gerryc89/Trigorilla-Pro/trigorilla_pro.sch

## EAGLE design trigorilla_pro.sch (2020-04-10)

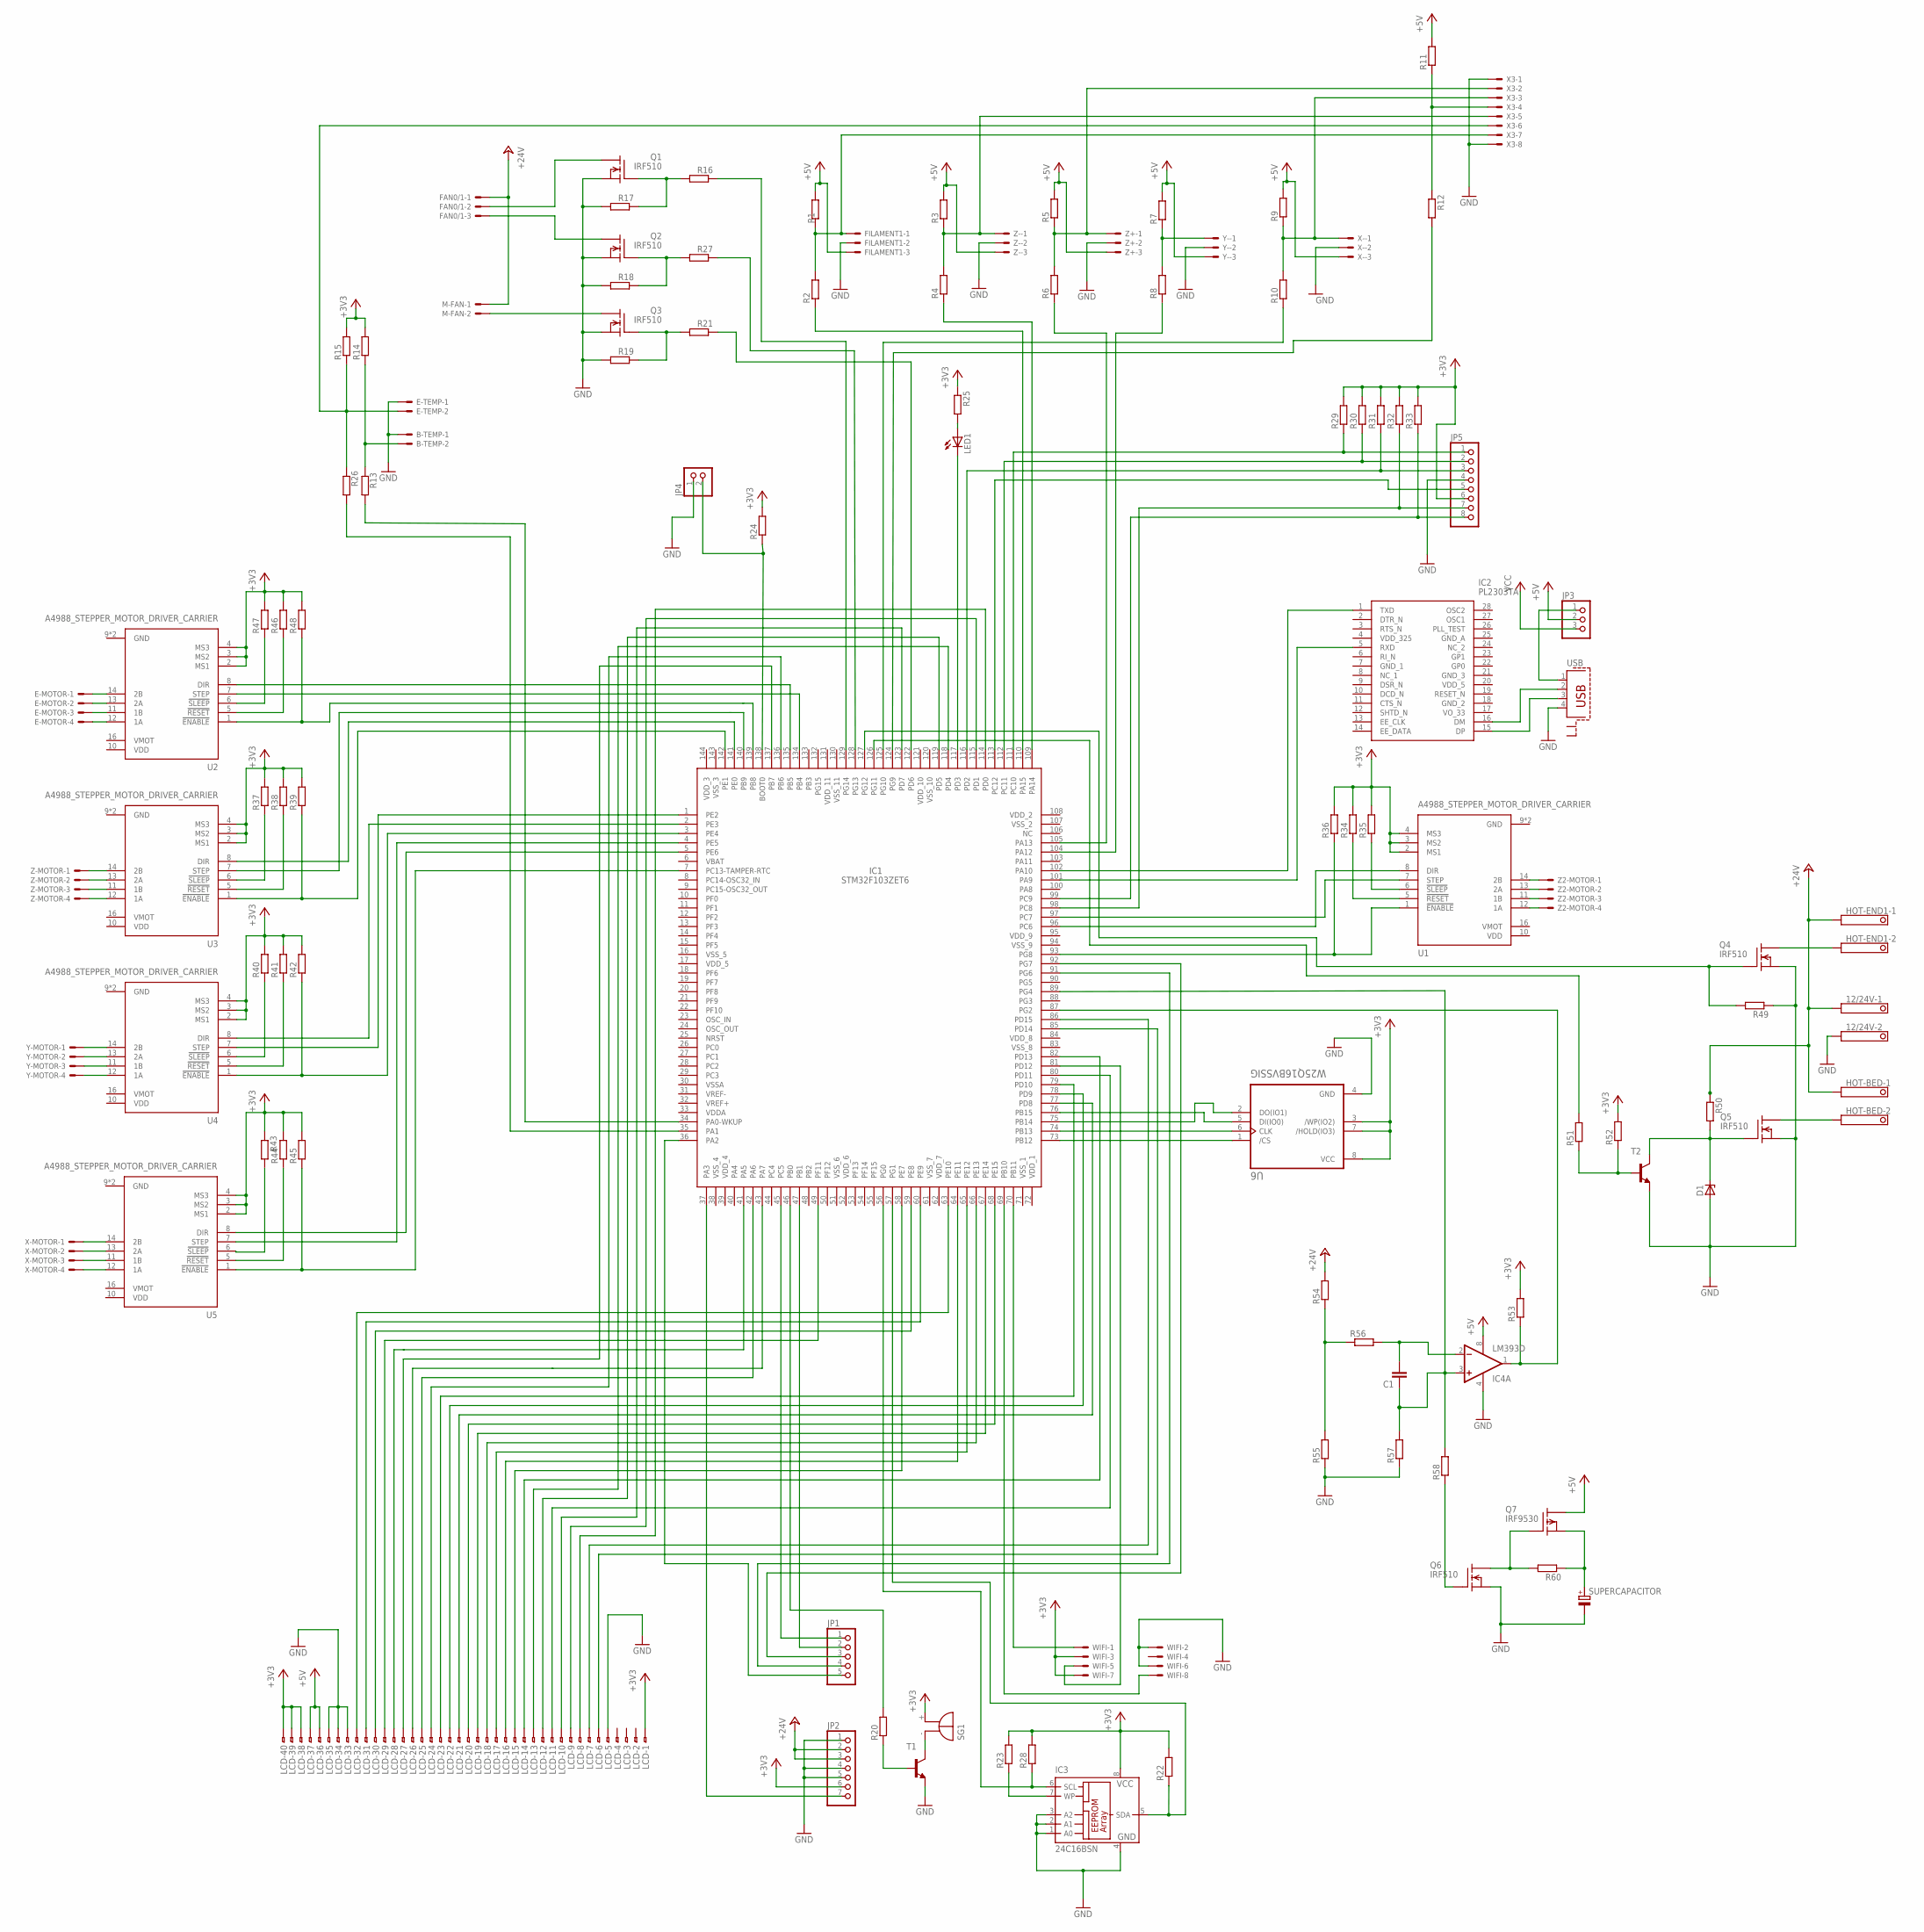
[picture p1: schematic trigorilla_pro.sch]

Parts:
12/24V: 1751248
B-TEMP: C-GRID-02-70543; 70543-02
C1: C-EUC0805; C0805
D1: ZENER-DIODESOD80C; SOD80C
E-MOTOR: C-GRID-04-70543; 70543-04
E-TEMP: C-GRID-02-70543; 70543-02
FAN0/1: C-GRID-03-70543; 70543-03
FILAMENT1: C-GRID-03-70543; 70543-03
HOT-BED: 1751248
HOT-END1: 1751248
IC1: STM32F103ZET6; QFP50P2200X2200X160-144N
IC2: PL2303TA; SOP65P780X200-28N
IC3: 24C16BSN; SO-08
IC4: LM393D; SO08
JP1: PINHD-1X5; 1X05
JP2: PINHD-1X7; 1X07
JP3: PINHD-1X3; 1X03
JP4: PINHD-1X2; 1X02
JP5: PINHD-1X8; 1X08
LCD: FH12-40S-0.5SH
LED1: LED; SMARTLED-TTW
M-FAN: C-GRID-02-70543; 70543-02
Q1, Q2, Q3, Q4, Q5, Q6: IRF510; TO220
Q7: IRF9530; TO220
R1, R2, R3, R4, R5, R6, R7, R8, R9, R10, R11, R12, R13, R14, R15, R16, R17, R18, R19, R20, R21, R22, R23, R24, R25, R26, R27, R28, R29, R30, R31, R32, R33, R34, R35, R36, R37, R38, R39, R40, R41, R42, R43, R44, R45, R46, R47, R48, R49, R50, R51, R52, R53, R54, R55, R56, R57, R58, R60: R-EU_M0805; M0805
SG1: F/QMBIII
SUPERCAPACITOR: CPOL-EUE10-22.5; EB22,5D
T1, T2: BC817-40-NPN-SOT23-BEC; SOT23-BEC
U1, U2, U3, U4, U5: A4988_STEPPER_MOTOR_DRIVER_CARRIER; MODULE_A4988_STEPPER_MOTOR_DRIVER_CARRIER
U6: W25Q16BVSSIG; SOIC127P790X216-8N
USB: PN61729-S
WIFI: 87758-0816
X3: C-GRID-08-70543; 70543-08
X-: C-GRID-03-70543; 70543-03
X-MOTOR: C-GRID-04-70543; 70543-04
Y-: C-GRID-03-70543; 70543-03
Y-MOTOR: C-GRID-04-70543; 70543-04
Z2-MOTOR: C-GRID-04-70543; 70543-04
Z+: C-GRID-03-70543; 70543-03
Z-: C-GRID-03-70543; 70543-03
Z-MOTOR: C-GRID-04-70543; 70543-04

Connections:
+3V3: IC3.8 (VCC), JP2.6, JP5.6, LCD.1, LCD.38, LCD.39, LCD.40, R14.2, R15.2, R22.2, R23.2, R24.2, R25.1, R28.2, R29.2, R30.2, R31.2, R32.2, R33.2, R34.2, R35.2, R36.2, R37.2, R38.2, R39.2, R40.2, R41.2, R42.2, R43.1, R44.2, R45.2, R46.2, R47.2, R48.2, R52.2, R53.2, SG1.+ (-), U1.2 (MS1), U1.3 (MS2), U1.4 (MS3), U2.2 (MS1), U2.3 (MS2), U2.4 (MS3), U3.2 (MS1), U3.3 (MS2), U3.4 (MS3), U4.2 (MS1), U4.3 (MS2), U4.4 (MS3), U5.2 (MS1), U5.3 (MS2), U5.4 (MS3), U6.3 (/WP(IO2)), U6.7 (/HOLD(IO3)), U6.8 (VCC), WIFI.3, WIFI.7
+5V: FILAMENT1.3, IC4.8 (V+), JP3.2, LCD.36, LCD.37, Q7.2 (D), R1.2, R3.2, R5.2, R7.2, R9.2, R11.2, X-.3, Y-.3, Z+.3, Z-.3
+24V: 12/24V.1, FAN0/1.1, HOT-BED.1, HOT-END1.1, JP2.2, JP2.3, M-FAN.1, R50.1, R54.2
.: IC1.57 (PG1), IC3.5 (SDA), R22.1
FILAMENT1: FILAMENT1.1, R1.1, R2.2, X3.7
GND: 12/24V.2, B-TEMP.1, D1.A, E-TEMP.1, FILAMENT1.2, IC3.1 (A0), IC3.2 (A1), IC3.3 (A2), IC3.4 (GND), IC4.4 (V-), JP2.1, JP2.4, JP2.5, JP4.1, JP5.4, LCD.5, LCD.33, LCD.34, LCD.35, Q1.3 (S), Q2.3 (S), Q3.3 (S), Q4.3 (S), Q5.3 (S), Q6.3 (S), R17.2, R18.2, R19.2, R49.1, R55.1, R57.1, SUPERCAPACITOR.-, T1.E, T2.E, U6.4 (GND), USB.4, WIFI.2, WIFI.6, X3.1, X3.8, X-.2, Y-.2, Z+.2, Z-.2
unnamed: R11.1, R12.1, X3.4
unnamed: R3.1, R4.2, X3.5, Z-.1
unnamed: R9.1, R10.2, X3.3, X-.1
unnamed: R5.1, R6.2, X3.2, Z+.1
unnamed: IC1.76 (PB15), U6.5 (DI(IO0))
unnamed: IC1.125 (PG10), R10.1
unnamed: IC1.104 (PA12), R8.1
unnamed: IC1.105 (PA13), R6.1
unnamed: IC1.109 (PA14), R4.1
unnamed: IC1.110 (PA15), R2.1
unnamed: IC1.124 (PG9), R12.2
unnamed: Q1.1 (G), R16.2, R17.1
unnamed: Q2.1 (G), R18.1, R27.2
unnamed: Q3.1 (G), R19.1, R21.2
unnamed: IC1.122 (PD6), R21.1
unnamed: FAN0/1.2, Q1.2 (D)
unnamed: FAN0/1.3, Q2.2 (D)
unnamed: M-FAN.2, Q3.2 (D)
unnamed: IC1.129 (PG14), R16.1
unnamed: IC1.128 (PG13), R27.1
unnamed: R43.2, U5.6 (!SLEEP)
unnamed: E-TEMP.2, R15.1, R26.2, X3.6
unnamed: IC1.35 (PA1), R26.1
unnamed: IC1.34 (PA0-WKUP), R13.1
unnamed: IC1.70 (PB11), WIFI.1
unnamed: IC1.69 (PB10), WIFI.8
unnamed: IC1.45 (PC5), JP1.1
unnamed: IC1.81 (PD12), WIFI.5
unnamed: IC1.47 (PB1), JP1.2
unnamed: IC1.92 (PG7), JP1.3
unnamed: IC1.91 (PG6), JP1.4
unnamed: IC1.36 (PA2), JP1.5
unnamed: IC1.37 (PA3), JP2.7
unnamed: IC1.117 (PD3), LED1.C@1 (C)
unnamed: LED1.A@1 (A), R25.2
unnamed: IC1.46 (PB0), R20.2
unnamed: R20.1, T1.B
unnamed: SG1.- (+), T1.C
unnamed: JP3.1, USB.1
unnamed: IC2.16 (DM), USB.2
unnamed: IC2.15 (DP), USB.3
unnamed: IC1.102 (PA10), IC2.1 (TXD)
unnamed: IC1.101 (PA9), IC2.5 (RXD)
unnamed: IC1.56 (PG0), IC3.6 (SCL), R28.1
unnamed: IC1.43 (PA7), LCD.26
unnamed: IC1.138 (BOOT0), JP4.2, R24.1
unnamed: IC1.111 (PC10), JP5.1, R29.1
unnamed: IC1.112 (PC11), JP5.2, R30.1
unnamed: IC1.116 (PD2), JP5.3, R31.1
unnamed: IC1.113 (PC12), JP5.5
unnamed: IC1.98 (PC8), JP5.7, R32.1
unnamed: IC1.99 (PC9), JP5.8, R33.1
unnamed: IC1.96 (PC6), U1.8 (DIR)
unnamed: IC1.97 (PC7), U1.7 (STEP)
unnamed: IC1.93 (PG8), R36.1, U1.1 (!ENABLE)
unnamed: U1.14 (2B), Z2-MOTOR.1
unnamed: U1.13 (2A), Z2-MOTOR.2
unnamed: U1.11 (1B), Z2-MOTOR.3
unnamed: U1.12 (1A), Z2-MOTOR.4
unnamed: R34.1, U1.5 (!RESET)
unnamed: R35.1, U1.6 (!SLEEP)
unnamed: IC1.139 (PB8), R48.1, U2.1 (!ENABLE)
unnamed: IC1.134 (PB4), U2.7 (STEP)
unnamed: IC1.135 (PB5), U2.8 (DIR)
unnamed: E-MOTOR.1, U2.14 (2B)
unnamed: R47.1, U2.6 (!SLEEP)
unnamed: R46.1, U2.5 (!RESET)
unnamed: E-MOTOR.2, U2.13 (2A)
unnamed: E-MOTOR.3, U2.11 (1B)
unnamed: E-MOTOR.4, U2.12 (1A)
unnamed: IC1.141 (PE0), U3.8 (DIR)
unnamed: IC1.140 (PB9), U3.7 (STEP)
unnamed: R37.1, U3.6 (!SLEEP)
unnamed: R38.1, U3.5 (!RESET)
unnamed: IC1.142 (PE1), R39.1, U3.1 (!ENABLE)
unnamed: U3.14 (2B), Z-MOTOR.1
unnamed: U3.13 (2A), Z-MOTOR.2
unnamed: U3.11 (1B), Z-MOTOR.3
unnamed: U3.12 (1A), Z-MOTOR.4
unnamed: IC1.1 (PE2), U4.7 (STEP)
unnamed: IC1.2 (PE3), U4.8 (DIR)
unnamed: IC1.3 (PE4), R42.1, U4.1 (!ENABLE)
unnamed: R40.1, U4.6 (!SLEEP)
unnamed: R41.1, U4.5 (!RESET)
unnamed: U4.14 (2B), Y-MOTOR.1
unnamed: U4.13 (2A), Y-MOTOR.2
unnamed: U4.11 (1B), Y-MOTOR.3
unnamed: U4.12 (1A), Y-MOTOR.4
unnamed: B-TEMP.2, R13.2, R14.1
unnamed: R44.1, U5.5 (!RESET)
unnamed: IC1.7 (PC13-TAMPER-RTC), R45.1, U5.1 (!ENABLE)
unnamed: IC1.4 (PE5), U5.7 (STEP)
unnamed: IC1.5 (PE6), U5.8 (DIR)
unnamed: U5.14 (2B), X-MOTOR.1
unnamed: U5.13 (2A), X-MOTOR.2
unnamed: U5.11 (1B), X-MOTOR.3
unnamed: U5.12 (1A), X-MOTOR.4
unnamed: R7.1, R8.2, Y-.1
unnamed: IC1.74 (PB13), U6.6 (CLK)
unnamed: IC1.73 (PB12), U6.1 (/CS)
unnamed: IC1.75 (PB14), U6.2 (DO(IO1))
unnamed: HOT-BED.2, Q5.2 (D)
unnamed: HOT-END1.2, Q4.2 (D)
unnamed: D1.C, Q5.1 (G), R50.2, T2.C
unnamed: IC1.127 (PG12), Q4.1 (G), R49.2
unnamed: R51.1, R52.1, T2.B
unnamed: IC1.126 (PG11), R51.2
unnamed: IC1.87 (PG2), IC4.1 (OUT), R53.1
unnamed: C1.2, IC4.2 (-IN), R56.2
unnamed: R54.1, R55.2, R56.1
unnamed: Q6.1 (G), R58.1
unnamed: C1.1, IC1.89 (PG4), IC4.3 (+IN), R57.2, R58.2
unnamed: Q6.2 (D), Q7.1 (G), R60.2
unnamed: Q7.3 (S), R60.1, SUPERCAPACITOR.+
unnamed: IC1.86 (PD15), LCD.7
unnamed: IC1.85 (PD14), LCD.6
unnamed: IC1.114 (PD0), LCD.8
unnamed: IC1.123 (PD7), LCD.10
unnamed: IC1.115 (PD1), LCD.9
unnamed: IC1.80 (PD11), LCD.11
unnamed: IC1.119 (PD5), LCD.12
unnamed: IC1.118 (PD4), LCD.13
unnamed: IC1.82 (PD13), LCD.14
unnamed: IC1.58 (PE7), LCD.15
unnamed: IC1.64 (PE11), LCD.16
unnamed: IC1.65 (PE12), LCD.17
unnamed: IC1.66 (PE13), LCD.18
unnamed: IC1.67 (PE14), LCD.19
unnamed: IC1.68 (PE15), LCD.20
unnamed: IC1.77 (PD8), LCD.21
unnamed: IC1.78 (PD9), LCD.22
unnamed: IC1.79 (PD10), LCD.23
unnamed: IC1.136 (PB6), LCD.24
unnamed: IC1.42 (PA6), LCD.25
unnamed: IC1.137 (PB7), LCD.27
unnamed: IC1.41 (PA5), LCD.28
unnamed: IC1.63 (PE10), LCD.32
unnamed: IC1.60 (PE9), LCD.31
unnamed: IC1.59 (PE8), LCD.30
unnamed: IC1.49 (PF11), LCD.29
unnamed: IC3.7 (WP), R23.1
VCC: JP3.3
